jorgelalberto/Neural-Net-on-Microcontroller/README.md

# Neural-Net-on-Microcontroller
An artificial neural network (ANN) that can be trained and tested on the Raspberry Pi Pico to correctly classify whether the number being fed into the network is a zero or one. Systems outside the microcontroller influence and respond to the results of the ANN.
