jorgelalberto/Neural-Net-on-Microcontroller/(list of files, drawings)

Other design files:
altium/ANN.PcbDoc
altium/ANN.SchDoc
altium/JuniorDesign_FinalProj.PrjPcb
